nobodyguy/greyhound_probe/README.md

# Greyhound probe
Greyhound probe is a fast and efficient Black Magic Probe compatible programmer and debugger
