nobodyguy/greyhound_probe/3D/TYPE-C-31-M-12--3DModel-STEP-56544.STEP

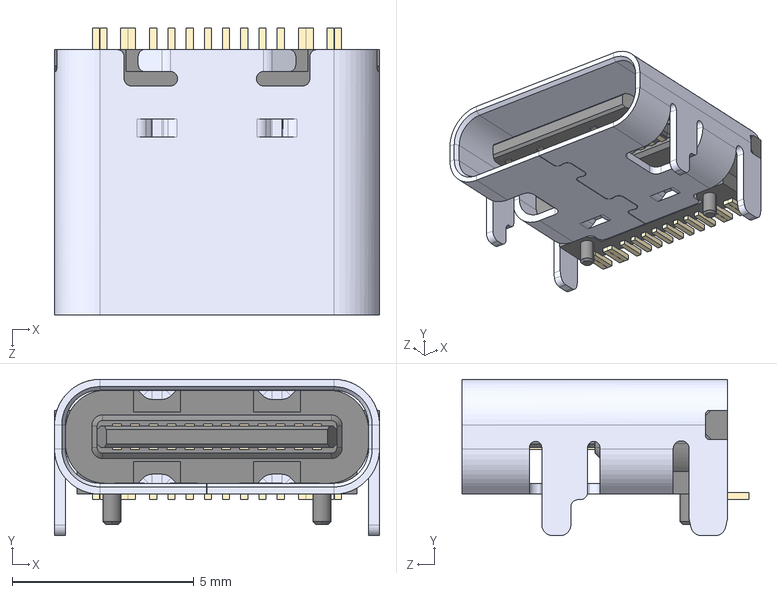
[picture p1: CAD file, 2022-08-31]
3D/TYPE-C-31-M-12--3DModel-STEP-56544.STEP
8.94 x 4.30 x 7.90 mm
