nobodyguy/greyhound_probe/3D/FTSH-105-01-L-DV-K-TR.stp

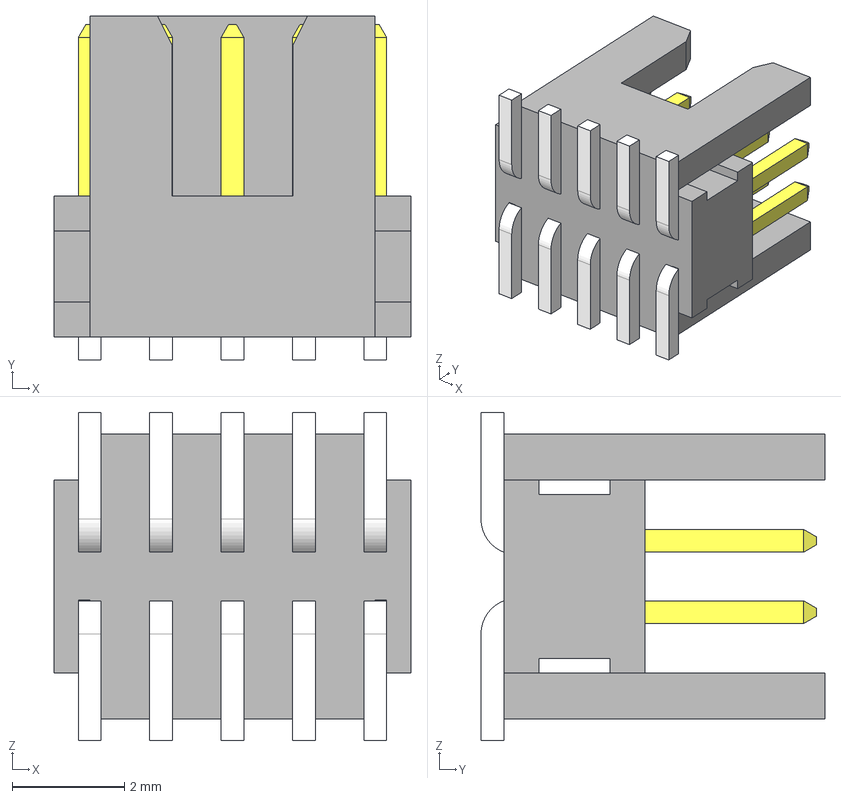
[picture p2: CAD file, 2022-08-31]
3D/FTSH-105-01-L-DV-K-TR.stp
6.35 x 6.12 x 5.84 mm
FTSH-105-01-L-DV-K-TR_pins2
FTSH-105-01-L-DV-K-TR_pins1
FTSH-105-01-L-DV-K-TR_body
