nobodyguy/greyhound_probe/greyhound_probe.kicad_pcb

## KiCad design greyhound_probe.kicad_pcb (2022-11-03)

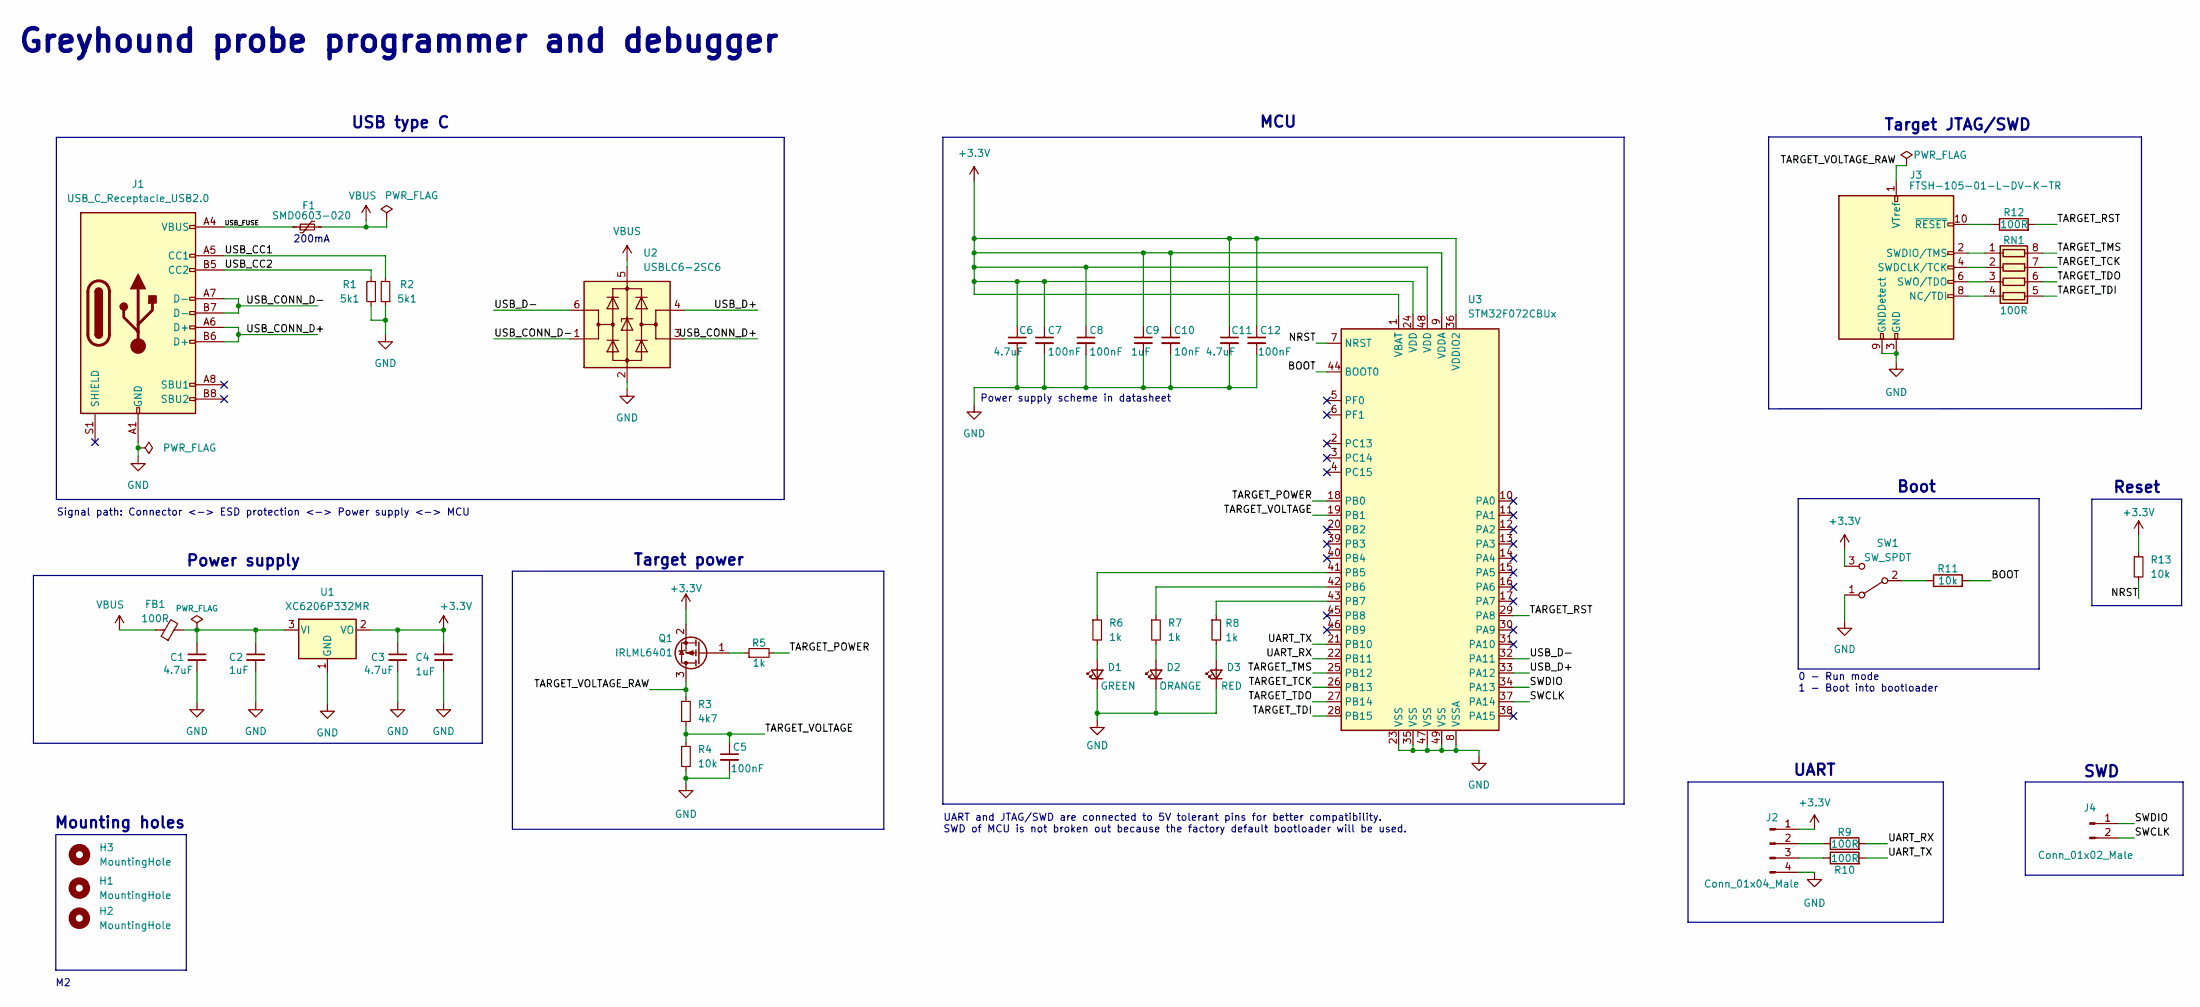
[picture p3: schematic greyhound_probe.kicad_sch, Greyhound probe programmer and debugger]

Parts:
C1, C3: 4.7uF; C_0603_1608Metric; LCSC Part C1592
C2, C4, C9: 1uF; C_0603_1608Metric; LCSC Part C1592
C5, C7, C8, C12: 100nF; C_0603_1608Metric; LCSC Part C66501
C6, C11: 4.7uF; C_0603_1608Metric; LCSC Part C8032
C10: 10nF; C_0603_1608Metric; LCSC Part C1589
D1: GREEN; D_0603_1608Metric; LCSC Part C72043
D2: ORANGE; D_0603_1608Metric; LCSC Part C146215
D3: RED; D_0603_1608Metric; LCSC Part C72044
F1: SMD0603-020; Fuse_0603_1608Metric; LCSC Part C2760255
FB1: 100R; L_0603_1608Metric; LCSC Part C74325
H1, H2, H3: MountingHole; MountingHole_2.2mm_M2
J1: USB_C_Receptacle_USB2.0; USB_C_Receptacle_HRO_TYPE-C-31-M-12; LCSC Part C165948
J2: Conn_01x04_Male; PinHeader_1x04_P2.54mm_Vertical; LCSC Part C2935910
J3: FTSH-105-01-L-DV-K-TR; PinHeader_2x05_P1.27mm_Vertical_SMD; LCSC Part C448647
J4: Conn_01x02_Male; PinHeader_1x02_P2.54mm_Vertical
Q1: IRLML6401; SOT-23; LCSC Part C518776
R1, R2: 5k1; R_0603_1608Metric; LCSC Part C105580
R3: 4k7; R_0603_1608Metric; LCSC Part C105428
R4, R13: 10k; R_0603_1608Metric
R5, R6, R7, R8: 1k; R_0603_1608Metric; LCSC Part C22548
R9, R10, R12: 100R; R_0603_1608Metric; LCSC Part C105588
R11: 10k; R_0603_1608Metric; LCSC Part C99198
RN1: 100R; R_Array_Convex_4x0603; LCSC Part C25506
SW1: SW_SPDT; SW_SPDT_PCM12; LCSC Part C514016
U1: XC6206P332MR; SOT-23; LCSC Part C5446
U2: USBLC6-2SC6; SOT-23-6; LCSC Part C2827654
U3: STM32F072CBUx; QFN-48-1EP_7x7mm_P0.5mm_EP5.6x5.6mm; LCSC Part C2054107

Connections:
+3.3V: C3.1, C4.1, C6.1, C7.1, C8.1, C9.1, C10.1, C11.1, C12.1, J2.1, Q1.2 (S), R13.1, SW1.3 (C), U1.2 (VO), U3.1 (VBAT), U3.9 (VDDA), U3.24 (VDD), U3.36 (VDDIO2), U3.48 (VDD)
/BOOT: R11.2, U3.44 (BOOT0)
/NRST: R13.2, U3.7 (NRST)
/SWCLK: J4.2, U3.37 (PA14)
/SWDIO: J4.1, U3.34 (PA13)
/TARGET_POWER: R5.2, U3.18 (PB0)
/TARGET_RST: R12.2, U3.29 (PA8)
/TARGET_TCK: RN1.7 (R2.2), U3.26 (PB13)
/TARGET_TDI: RN1.5 (R4.2), U3.28 (PB15)
/TARGET_TDO: RN1.6 (R3.2), U3.27 (PB14)
/TARGET_TMS: RN1.8 (R1.2), U3.25 (PB12)
/TARGET_VOLTAGE: C5.1, R3.2, R4.1, U3.19 (PB1)
/TARGET_VOLTAGE_RAW: J3.1 (VTref), Q1.3 (D), R3.1
/UART_RX: R9.2, U3.22 (PB11)
/UART_TX: R10.2, U3.21 (PB10)
/USB_CC1: J1.A5 (CC1), R2.2
/USB_CC2: J1.B5 (CC2), R1.2
/USB_CONN_D+: J1.A6 (D+), J1.B6 (D+), U2.3 (I/O2)
/USB_CONN_D-: J1.A7 (D-), J1.B7 (D-), U2.1 (I/O1)
/USB_D+: U2.4 (I/O2), U3.33 (PA12)
/USB_D-: U2.6 (I/O1), U3.32 (PA11)
/USB_FUSE: F1.1, J1.A4 (VBUS), J1.A9 (VBUS), J1.B4 (VBUS), J1.B9 (VBUS)
GND: C1.2, C2.2, C3.2, C4.2, C5.2, C6.2, C7.2, C8.2, C9.2, C10.2, C11.2, C12.2, D1.1 (K), D2.1 (K), D3.1 (K), J1.A1 (GND), J1.A12 (GND), J1.B1 (GND), J1.B12 (GND), J2.4, J3.3 (GND), J3.5 (GND), J3.9 (GNDDetect), R1.1, R2.1, R4.2, SW1.1 (A), U1.1 (GND), U2.2 (GND), U3.8 (VSSA), U3.23 (VSS), U3.35 (VSS), U3.47 (VSS), U3.49 (VSS)
unnamed: C1.1, C2.1, FB1.2, U1.3 (VI)
unnamed: D1.2 (A), R6.2
unnamed: D2.2 (A), R7.2
unnamed: D3.2 (A), R8.2
unnamed: J2.2, R9.1
unnamed: J2.3, R10.1
unnamed: J3.2 (SWDIO/TMS), RN1.1 (R1.1)
unnamed: J3.4 (SWDCLK/TCK), RN1.2 (R2.1)
unnamed: J3.6 (SWO/TDO), RN1.3 (R3.1)
unnamed: J3.8 (NC/TDI), RN1.4 (R4.1)
unnamed: J3.10 (~RESET), R12.1
unnamed: Q1.1 (G), R5.1
unnamed: R6.1, U3.41 (PB5)
unnamed: R7.1, U3.42 (PB6)
unnamed: R8.1, U3.43 (PB7)
unnamed: R11.1, SW1.2 (B)
VBUS: F1.2, FB1.1, U2.5 (VBUS)

Notes on the sheet:
Boot
Reset
Power supply
200mA
Greyhound probe programmer and debugger
Target power
0 - Run mode 1 - Boot into bootloader
UART
MCU
Signal path: Connector <-> ESD protection <-> Power supply <-> MCU
SWD
Target JTAG/SWD
Power supply scheme in datasheet
Mounting holes
UART and JTAG/SWD are connected to 5V tolerant pins for better compatibility. SWD of MCU is not broken out because the factory default bootloader will be used.
USB type C

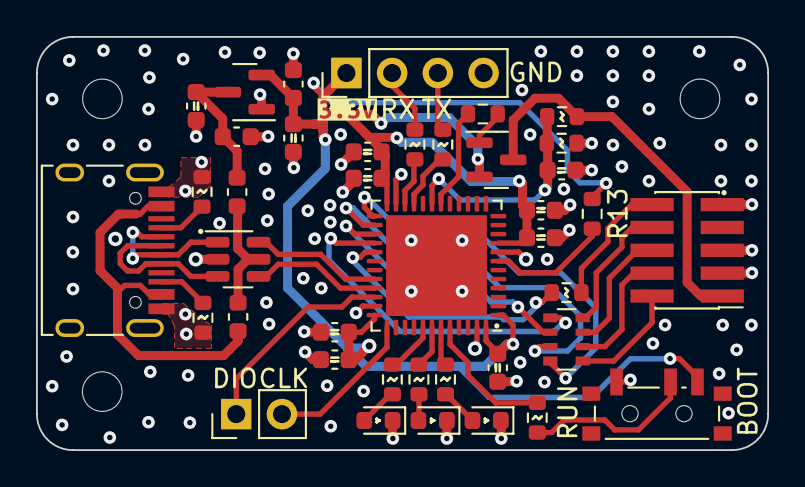
[picture p4: board greyhound_probe.kicad_pcb from above]

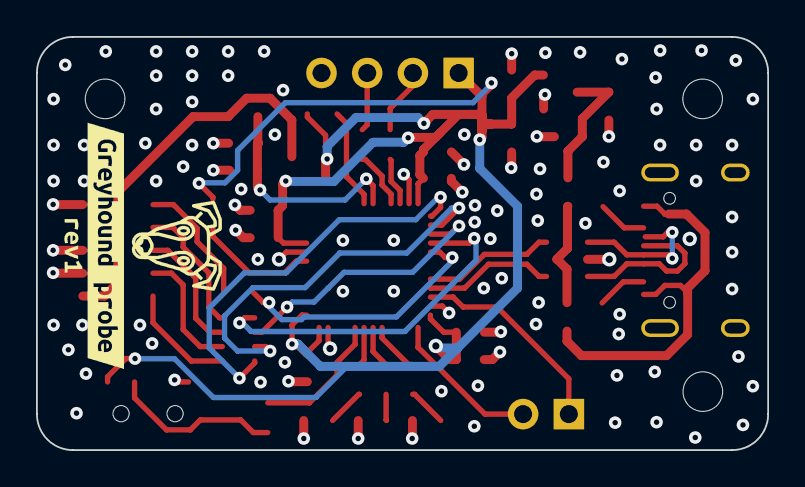
[picture p5: board greyhound_probe.kicad_pcb from below]

Board: 4 copper layers, 40.6 x 23.0 mm, 46 parts (2 on the bottom side), 40 nets.

Other parts of the board:
kibuzzard-6360FEA6: G***; kibuzzard-6360FEA6
kibuzzard-63127F62: G***; kibuzzard-63127F62
kibuzzard-63139EF8: G***; kibuzzard-63139EF8
