nobodyguy/greyhound_probe/(commit log)

2022-08-19 Initial schematic - USB, power supply and MCU decoupling
    [greyhound_probe.kicad_pcb, greyhound_probe.kicad_sch]
2022-08-21 Power supply rework, jtag connector finished
    [greyhound_probe.kicad_sch]
2022-08-23 Led resistors changed, boot button
    [greyhound_probe.kicad_sch]
2022-08-31 Added UART, started with PCB sectioning
    [FTSH-105-01-L-DV-K-TR.stp, TYPE-C-31-M-12--3DModel-STEP-56544.STEP, greyhound_probe.kicad_pcb, greyhound_probe.kicad_sch]
2022-09-01 Fixed short and power symbols
    [greyhound_probe.kicad_pcb, greyhound_probe.kicad_sch]
2022-09-02 PCB positioning changes, silkscreen changes
    [greyhound_probe.kicad_pcb, greyhound_probe.kicad_sch]
2022-09-02 Routing mostly done, rough board outline
    [greyhound_probe.kicad_pcb, greyhound_probe.kicad_sch]
2022-09-03 Routed the rest of pins, rounded corners, mounting holes placing
    [greyhound_probe.kicad_pcb]
2022-09-03 Added silkscreen labels
    [greyhound_probe.kicad_pcb]
2022-09-04 Via stitching done
    [greyhound_probe.kicad_pcb]
2022-09-04 LED vias moved a bit farther from silkscreen
    [greyhound_probe.kicad_pcb]
2022-09-09 Better spacing of a few signal traces and vias
    [greyhound_probe.kicad_pcb, greyhound_probe.kicad_sch]
2022-11-01 Added SWD, rearranged bottom part
    [greyhound_probe.kicad_pcb, greyhound_probe.kicad_sch]
2022-11-03 Added in series resistor to mosfet gate, nrst pullup, more regulator caps, reduced via sharing
    [greyhound_probe.kicad_pcb, greyhound_probe.kicad_sch]
