nobodyguy/greyhound_probe/(notices)

Notices in the files:
3D/FTSH-105-01-L-DV-K-TR.stp:
author */ ('License CC BY-ND 4.0'),
